gyarab/Smart-Box/Dokumentace/SmartBox - poster.jpeg

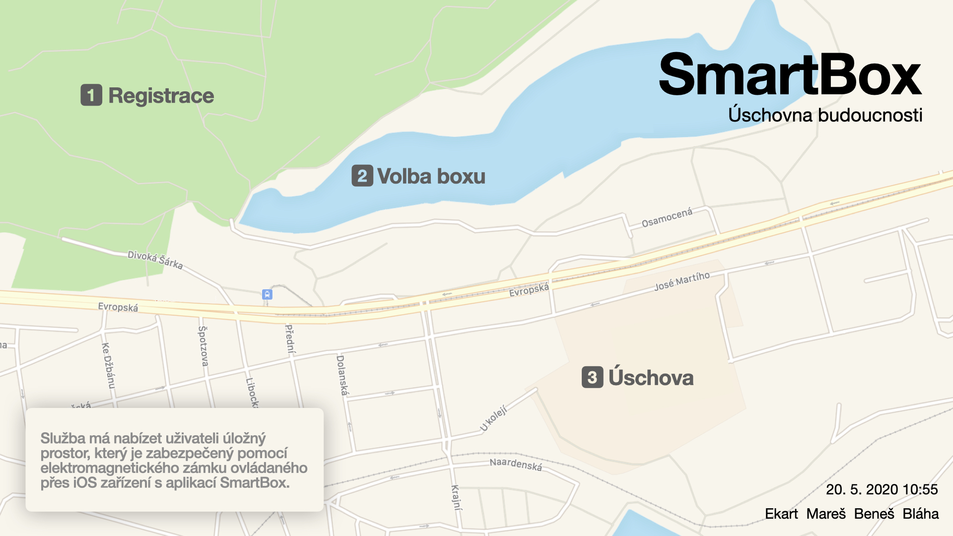
Dokumentace/SmartBox - poster.jpeg
