gyarab/Smart-Box/Dokumentace/PCB - circuit.pdf

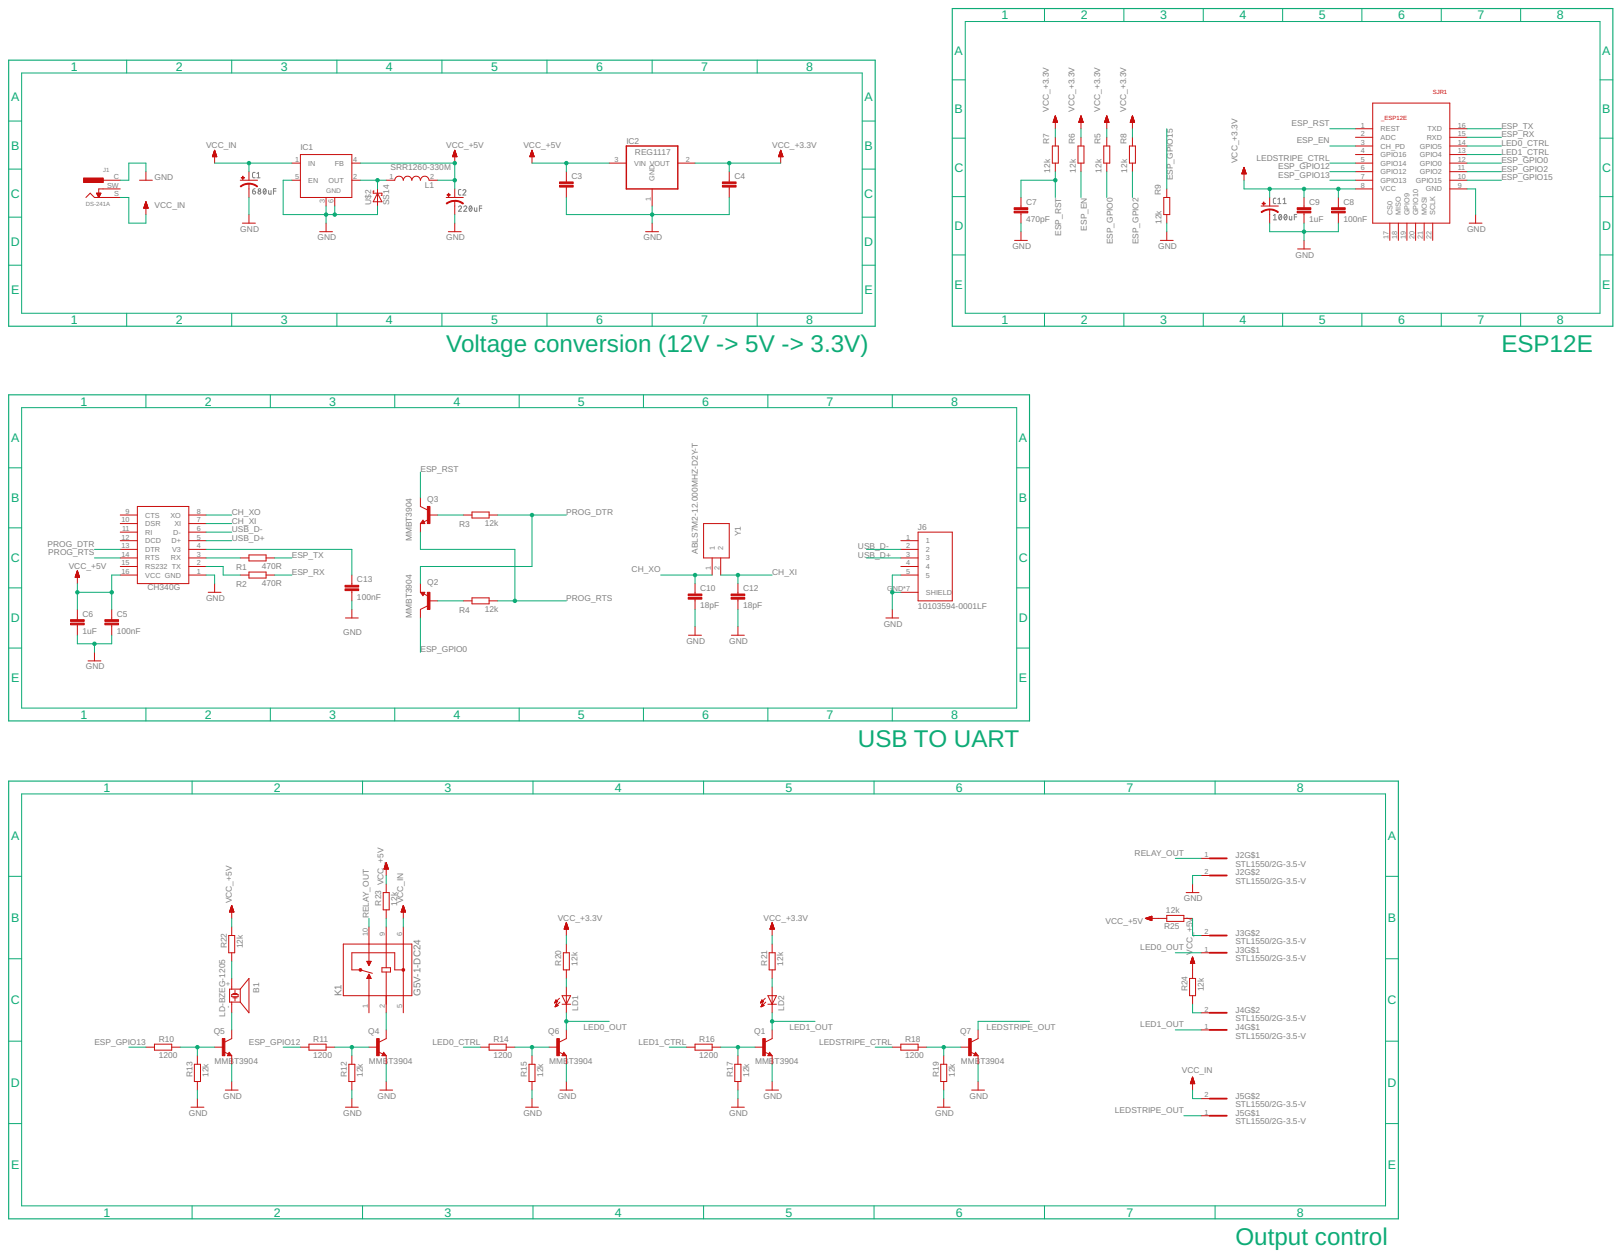
[picture p6: page 1]

RELAY_OUT 1 J2G$1 STL1550/2G-3.5-V 2 J2G$2 STL1550/2G-3.5-V 2 J5G$2 STL1550/2G-3.5-V LEDSTRIPE_OUT 1 J5G$1 STL1550/2G-3.5-V
