gyarab/Smart-Box/Dokumentace/PCB - board.pdf

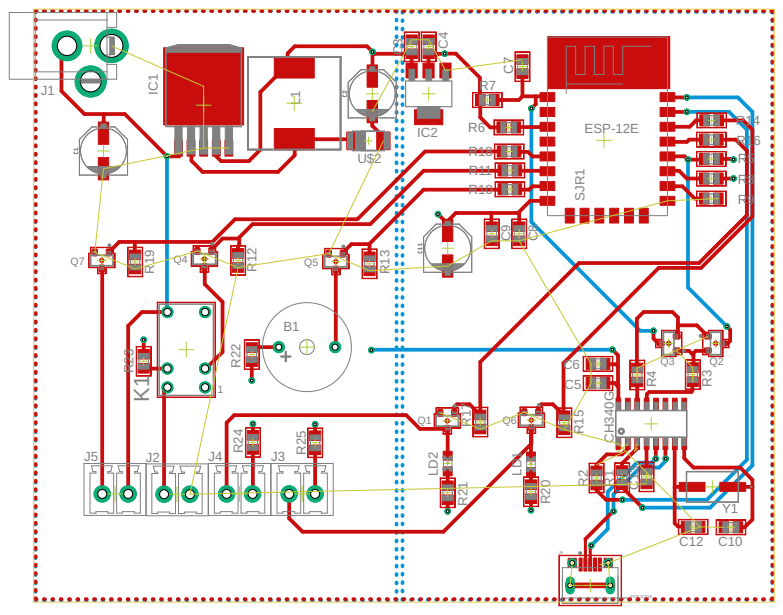
[picture p7: page 1]
