gyarab/Smart-Box/Dokumentace/Prototype - circuit.pdf

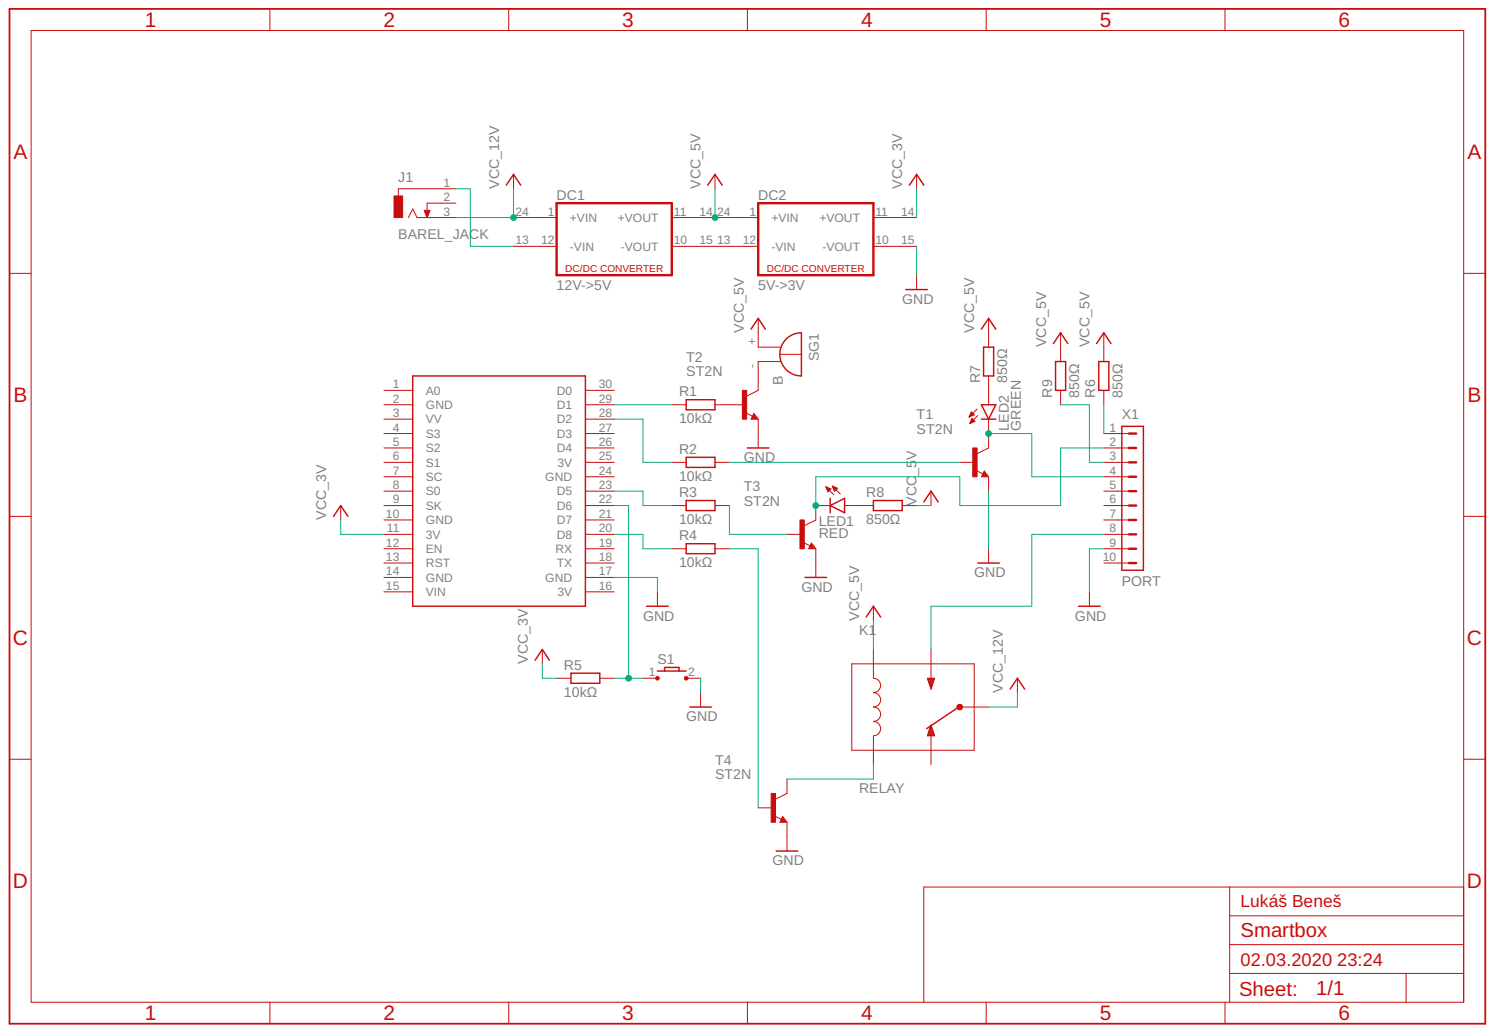
[picture p8: page 1]
