gyarab/Smart-Box/Eagle/pvc/Smartbox.brd

## EAGLE design Eagle/pvc/Smartbox.brd (2020-04-29)

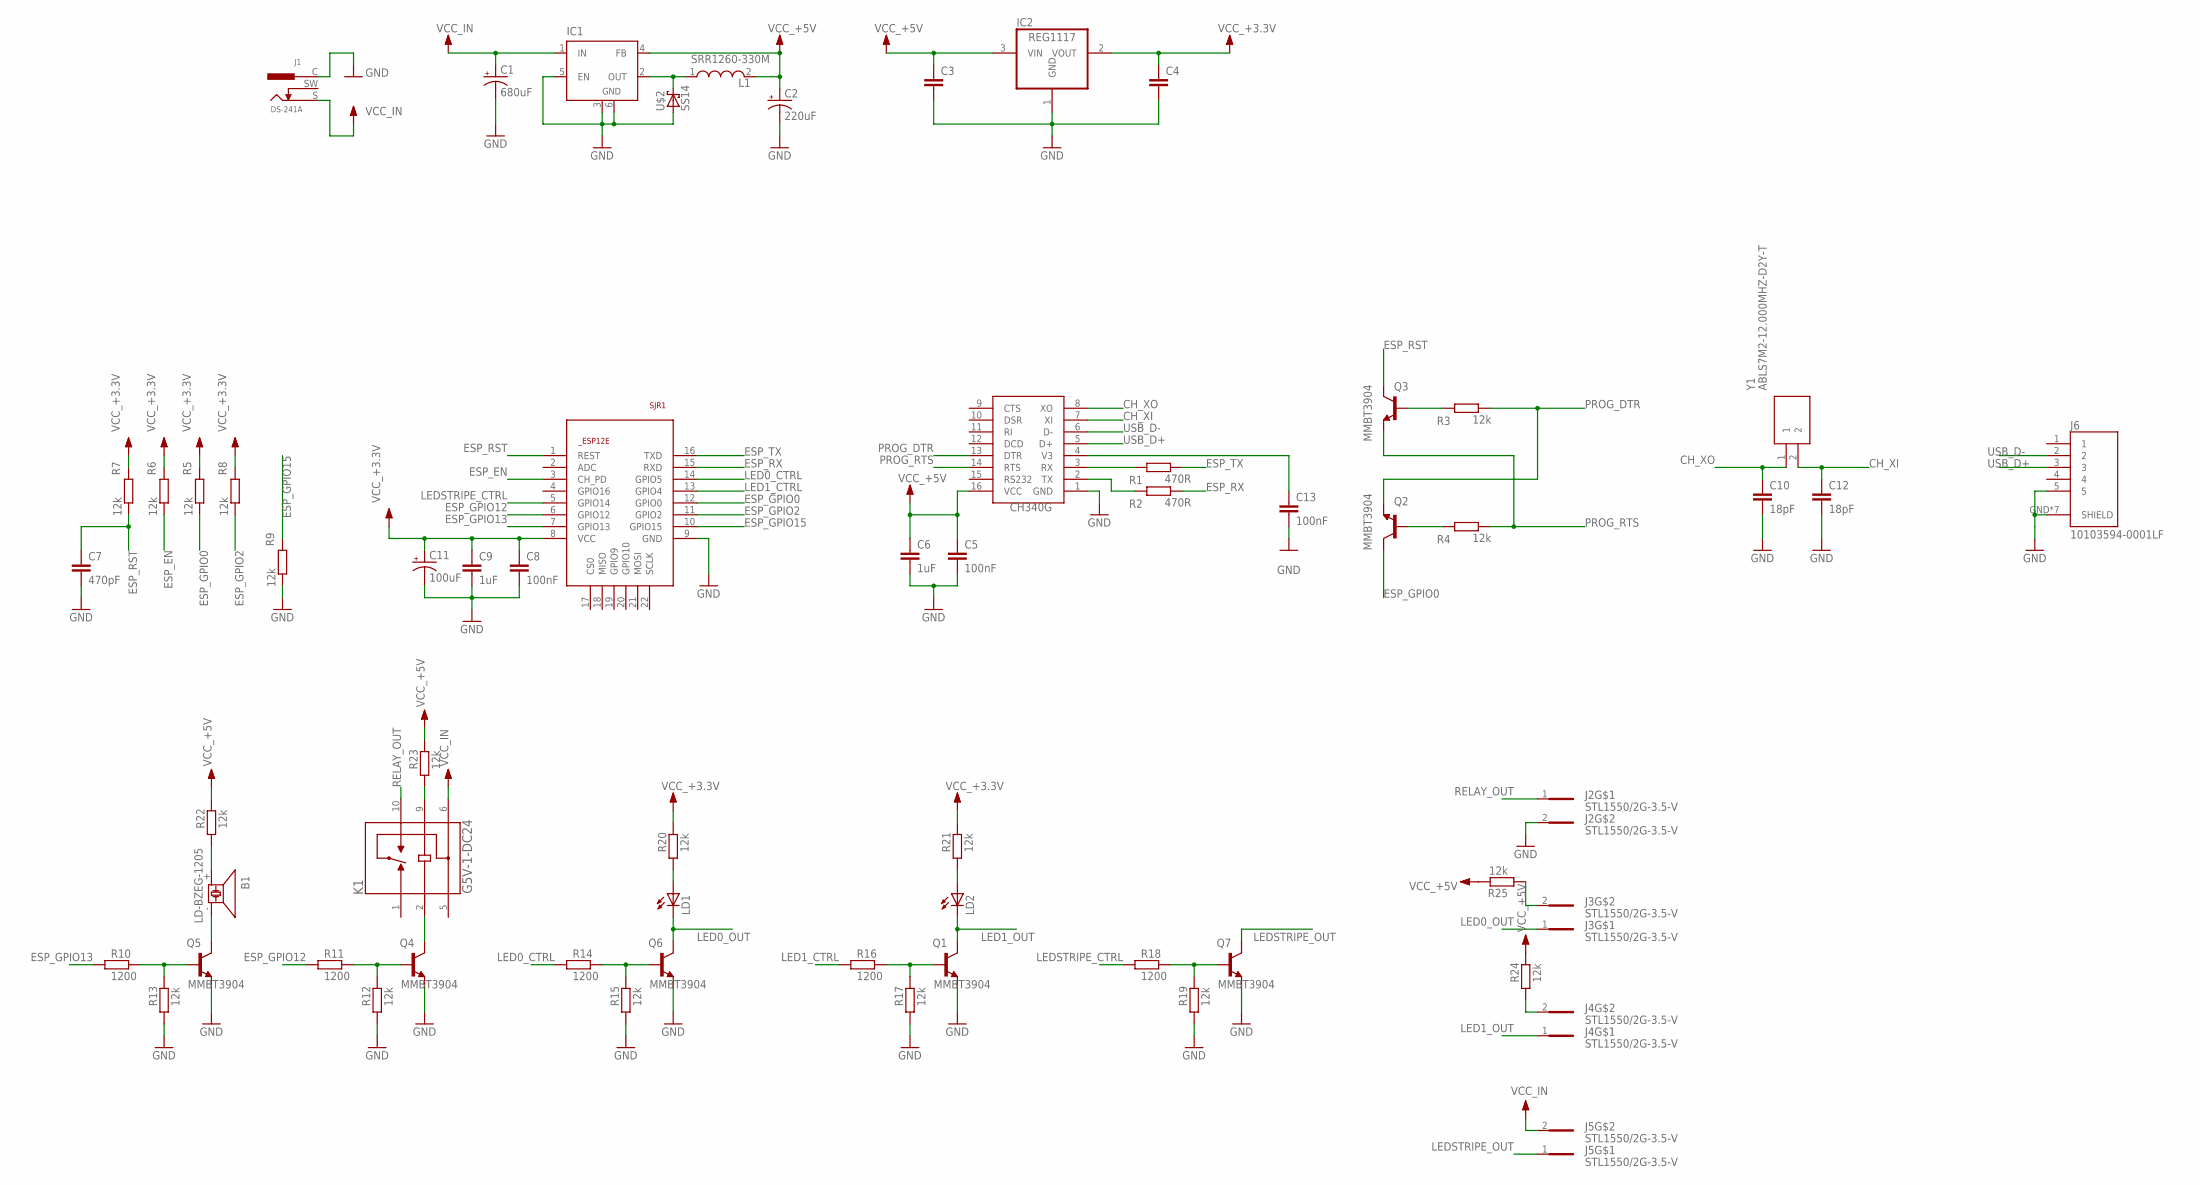
[picture p9: schematic Smartbox.sch, Opto Real Variant]

Parts:
B1: LD-BZEG-1205; LD-BZEG-12XX
C1: 680uF; PANASONIC_D
C2: 220uF; PANASONIC_D
C3, C4: C-EUC0805; C0805
C5, C8, C13: 100nF; C0805
C6, C9: 1uF; C0805
C7: 470pF; C0805
C10, C12: 18pF; C0805
C11: 100uF; PANASONIC_D
IC1: LM2596S; TO263-5
IC2: REG1117; SOT223
J1: DS-241A; DS-241
J2, J3, J4, J5: STL1550/2G-3.5-V; STL1550/2G-3.5-V-GREEN
J6: 10103594-0001LF
K1: G5V-1-DC24
L1: SRR1260-330M; SRR1260-150M
LD1, LD2: LEDCHIPLED_0805; CHIPLED_0805
Q1, Q2, Q3, Q4, Q5, Q6, Q7: MMBT3904; SOT23
R1, R2: 470R; R0805
R3, R4, R5, R6, R7, R8, R9, R12, R13, R15, R17, R19, R20, R21, R22, R23, R24, R25: 12k; R0805
R10, R11, R14, R16, R18: 1200; R0805
SJR1: ESP8266-12EESP12E; ESP8266-ESP12E
U$2: SS14; DO-214AC
U$3: CH340G; SOIC16
Y1: ABLS7M2-12.000MHZ-D2Y-T; ABLS7M216000MHZD2YT

Connections:
CH_XI: C12.1, U$3.7 (XI), Y1.2
CH_XO: C10.1, U$3.8 (XO), Y1.1
ESP_EN: R6.2, SJR1.3 (CH_PD)
ESP_GPIO0: Q2.3 (C), R5.2, SJR1.12 (GPIO0)
ESP_GPIO2: R8.2, SJR1.11 (GPIO2)
ESP_GPIO12: R11.1, SJR1.6 (GPIO12)
ESP_GPIO13: R10.1, SJR1.7 (GPIO13)
ESP_GPIO15: R9.1, SJR1.10 (GPIO15)
ESP_RST: C7.1, Q3.3 (C), R7.2, SJR1.1 (REST)
ESP_RX: R2.2, SJR1.15 (RXD)
ESP_TX: R1.2, SJR1.16 (TXD)
GND: C1.-, C2.-, C3.2, C4.2, C5.2, C6.2, C7.2, C8.2, C9.2, C10.2, C11.-, C12.2, C13.1, IC1.3 (GND), IC1.5 (EN), IC1.6 (GND), IC2.1 (GND), J1.C, J2.2, J6.5, J6.GND (SHIELD), J6.GND$1 (SHIELD), J6.GND$2 (SHIELD), J6.S1 (SHIELD), J6.S2 (SHIELD), J6.S3 (SHIELD), J6.S4 (SHIELD), Q1.2 (E), Q4.2 (E), Q5.2 (E), Q6.2 (E), Q7.2 (E), R9.2, R12.1, R13.1, R15.1, R17.1, R19.1, SJR1.9 (GND), U$2.A, U$3.1 (GND)
LED0_CTRL: R14.1, SJR1.14 (GPIO5)
LED0_OUT: J3.1, LD1.C, Q6.3 (C)
LED1_CTRL: R16.1, SJR1.13 (GPIO4)
LED1_OUT: J4.1, LD2.C, Q1.3 (C)
LEDSTRIPE_CTRL: R18.1, SJR1.5 (GPIO14)
LEDSTRIPE_OUT: J5.1, Q7.3 (C)
unnamed: C13.2, U$3.4 (V3)
unnamed: R1.1, U$3.3 (RX)
unnamed: K1.2, Q4.3 (C)
unnamed: Q5.1 (B), R10.2, R13.2
unnamed: B1.-, Q5.3 (C)
unnamed: Q1.1 (B), R16.2, R17.2
unnamed: Q4.1 (B), R11.2, R12.2
unnamed: Q6.1 (B), R14.2, R15.2
unnamed: Q7.1 (B), R18.2, R19.2
unnamed: LD1.A, R20.1
unnamed: LD2.A, R21.1
unnamed: B1.+, R22.1
unnamed: K1.9, R23.1
unnamed: J4.2, R24.1
unnamed: J3.2, R25.1
unnamed: R2.1, U$3.2 (TX)
unnamed: Q2.1 (B), R4.1
unnamed: Q3.1 (B), R3.1
unnamed: IC1.2 (OUT), L1.1, U$2.C
PROG_DTR: Q2.2 (E), R3.2, U$3.13 (DTR)
PROG_RTS: Q3.2 (E), R4.2, U$3.14 (RTS)
RELAY_OUT: J2.1, K1.10
USB_D+: J6.3, U$3.5 (D+)
USB_D-: J6.2, U$3.6 (D-)
VCC_+3.3V: C4.1, C8.1, C9.1, C11.+, IC2.2 (VOUT), R5.1, R6.1, R7.1, R8.1, R20.2, R21.2, SJR1.8 (VCC)
VCC_+5V: C2.+, C3.1, C5.1, C6.1, IC1.4 (FB), IC2.3 (VIN), L1.2, R22.2, R23.2, R24.2, R25.2, U$3.16 (VCC)
VCC_IN: C1.+, IC1.1 (IN), J1.S, J5.2, K1.6

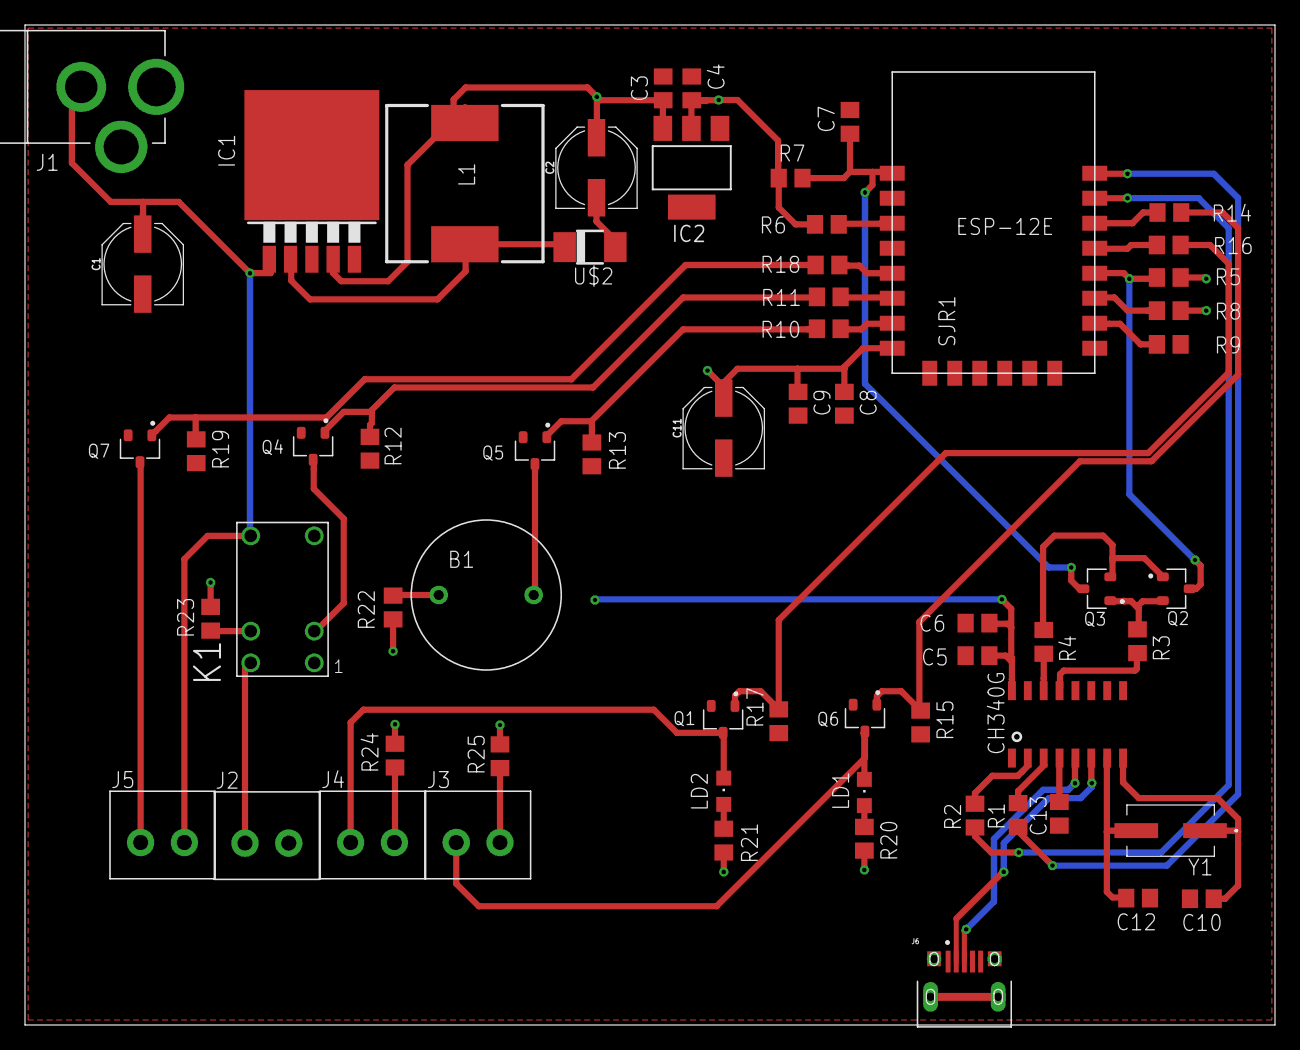
[picture p10: board Smartbox.brd from above]

Board: 2 copper layers, 100.0 x 80.0 mm, 62 parts (0 on the bottom side), 45 nets.
