gyarab/Smart-Box/DjangoAPI/smartboxrestapi/api/serializers.py

from rest_framework import serializers
from .models import User, Box

class UserSerializer(serializers.ModelSerializer):
    class Meta:
        model = User
        fields = '__all__'

class BoxSerializer(serializers.ModelSerializer):
    class Meta:
        model = Box
        fields = ['id', 'lattitude', 'longtitude', 'locked', 'name', 'current_owner']
